thieu-b55/High-Precision-Chronometer/README.md

# High-Precision-Chronometer with web-page

Chronometer with GPS time base from microseconds up to 99h59m59s999ms999µs

STM32F411CEU as timer 

ESP32-WROOM for storing times in SPIFFS flash memory and for web-page with all stored times

up to 500 times can be stored
